rhkean/kicad_DemonEye/DemonEye.kicad_pcb

## KiCad design DemonEye.kicad_pcb (2026-07-26)

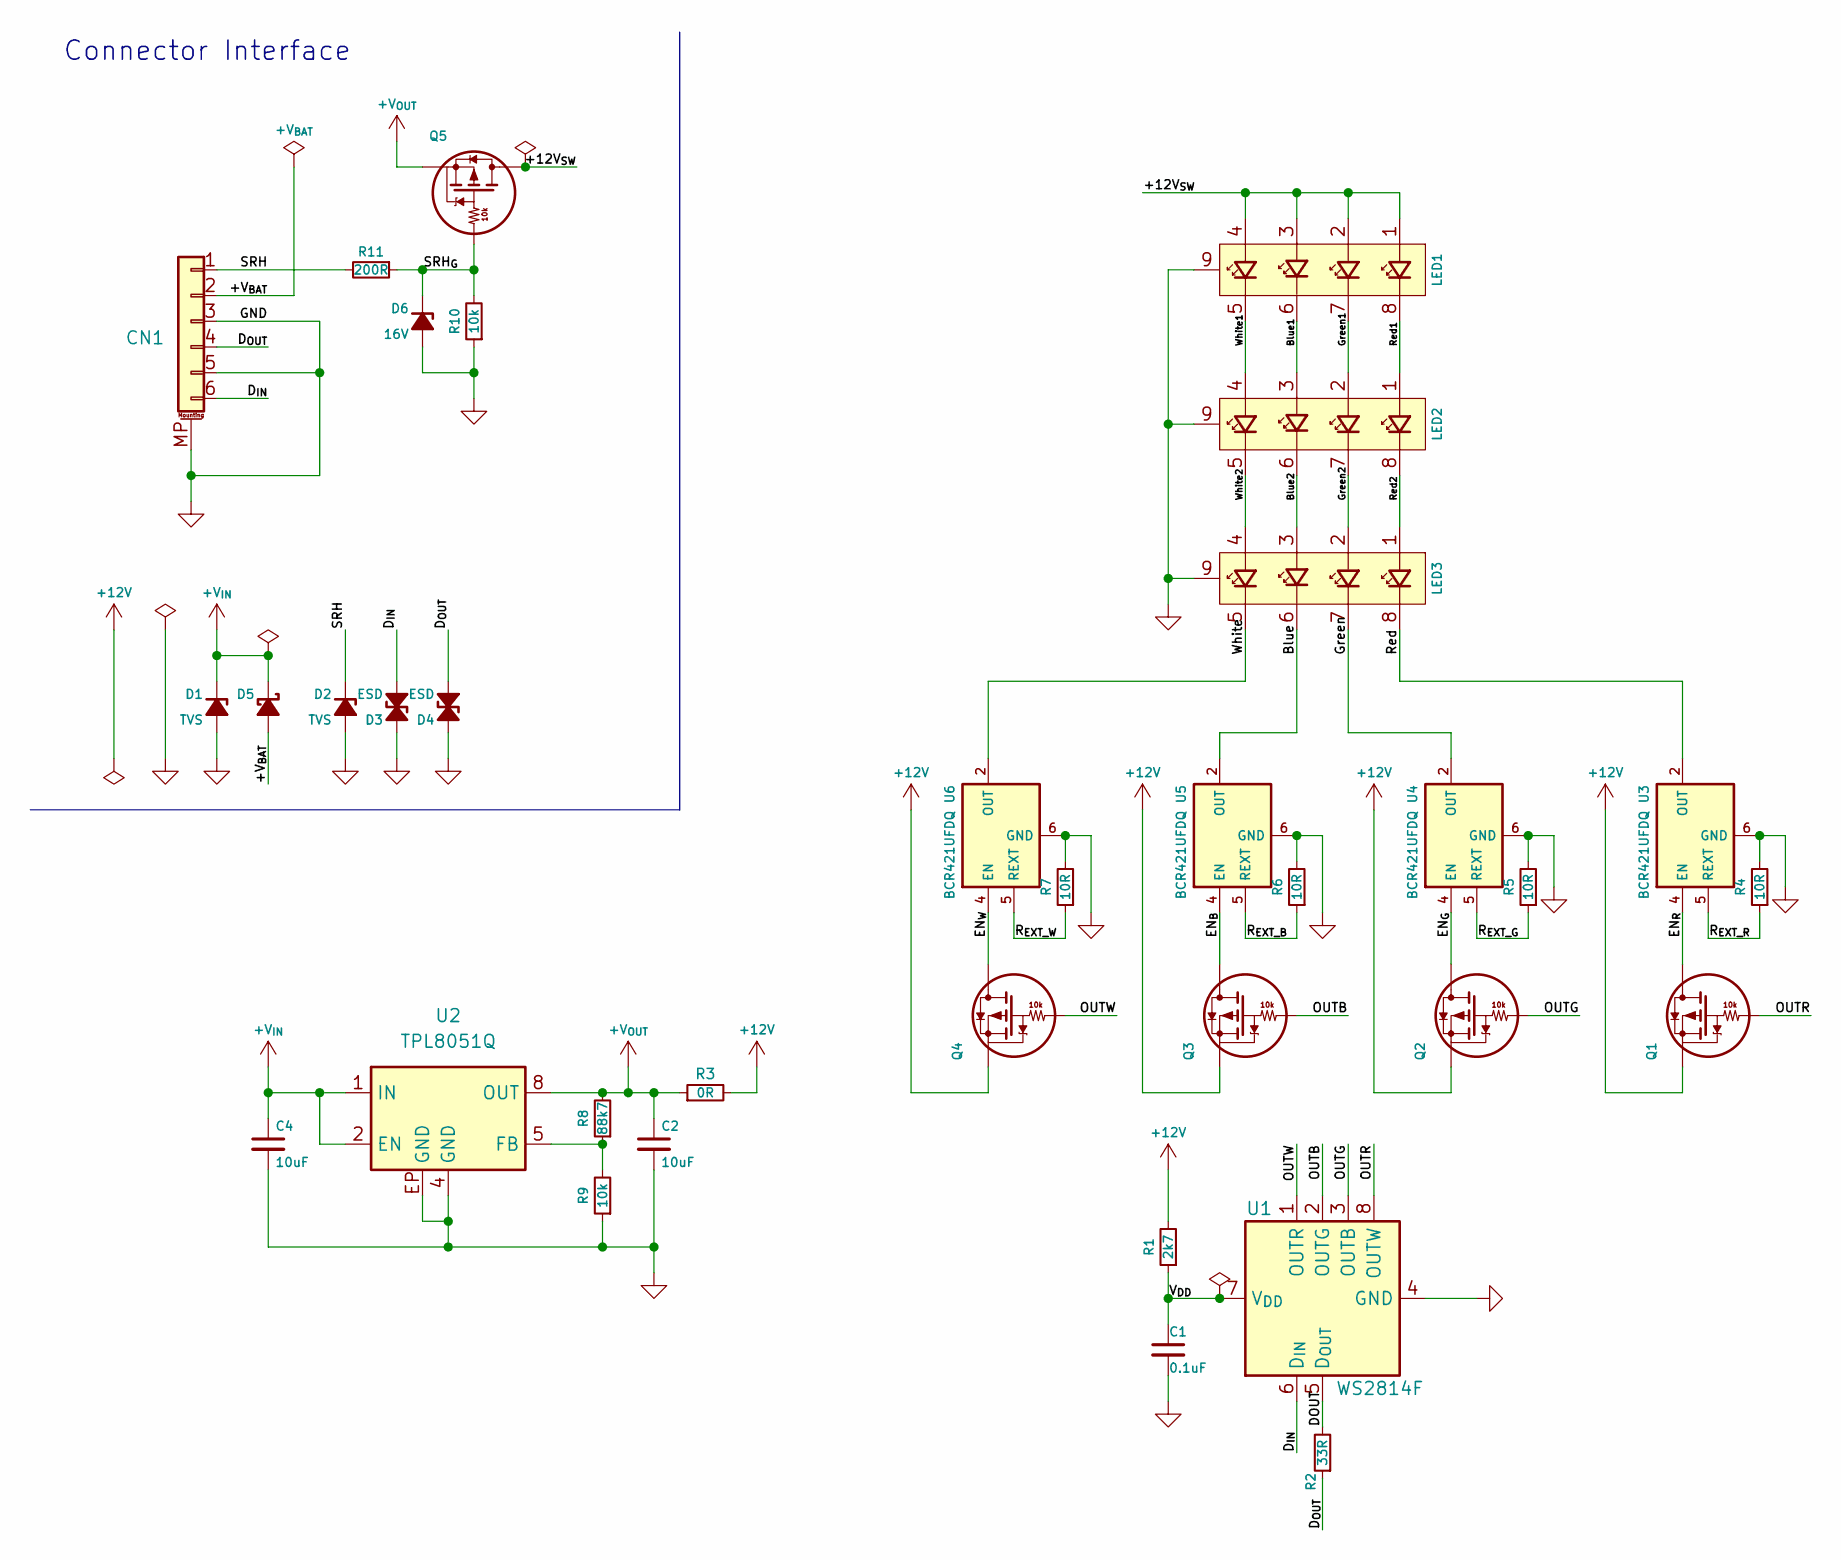
[picture p1: schematic DemonEye.kicad_sch]

Parts:
C1: 0.1uF; C_0201_Nominal; Manufacturer Part Number GRT033R61E104KE01D; LCSC C915760
C2, C4: 10uF; C_0805_Nominal; Manufacturer Part Number GCM21BC71E106KE36L; LCSC C5367383
CN1: PicoBlade 1x06 P1.25mm; Molex_PicoBlade_53261-0671_1x06_P1.25mm_Horizontal_SMD; Manufacturer Part Number HC-1.25-6PWT; LCSC C2845383
D1, D2: TVS; DFN1006-2; Manufacturer Part Number D15V0H1U2LP-7B; LCSC C1973850
D3, D4: ESD; DFN1006-2; Manufacturer Part Number SZESD7241N2T5G; LCSC C604770
D5: D_Schottky_Small_Filled; DFN1006-2; MPN NSVR05F40NXT5G; LCSC C604383
D6: 16V; DFN1006-2; Manufacturer Part Number BZX884-C16,315; LCSC C551222
LED1, LED2, LED3: QLSP06RGBXWAJ; Manufacturer Part Number QLSP06RGBXWAJ; LCSC C17645191
Q1, Q2, Q3, Q4, Q5: CSD25501F3; Texas_PICOSTAR-YJN_0.7x0.6mm_PicoStar; Manufacturer Part Number CSD25501F3; LCSC C2872196
R1: 2k7; R_0201_Dense; Manufacturer Part Number AC0201FR-072K7L; LCSC C226497
R2: 33R; R_0402_Nominal; Manufacturer Part Number AC0402FR-0733RL; LCSC C227000
R3: 0R; R_0603_Nominal; Manufacturer Part Number AC0603FR-070RL; LCSC C116699
R4, R5, R6, R7: 10R; R_0201_Dense; MPN AF0201FR-0710RL; LCSC C143979
R8: 88k7; R_0201_Dense; Manufacturer Part Number 0201WMF8872TEE; LCSC C423412
R9: 10k; R_0201_Dense; Manufacturer Part Number AC0201FR-0710KL; LCSC C144833
R10: 10k; R_0201_Nominal; Manufacturer Part Number AC0201FR-0710KL; LCSC C144833
R11: 200R; R_0402_Nominal; Manufacturer Part Number RC0402FR-07200RL; LCSC C114764
U1: WS2814F; FSOP-8_3.25x1.65mm_P0.8mm; Manufacturer Part Number WS2814F; LCSC C5446694
U2: TPL8051Q; DFN-8-1EP_3x3mm_P0.65mm_EP1.55x2.4mm; MPN TPL8051ADQ-DFCR-S; LCSC C48618279
U3, U4, U5, U6: BCR421UFDQ; Manufacturer Part Number BCR421UFDQ-7; LCSC C2678624

Connections:
+12V: Q1.2 (S), Q2.2 (S), Q3.2 (S), Q4.2 (S), R1.2, R3.2
+V_{IN}: C4.1, D1.1 (K), D5.1 (K), U2.1 (IN), U2.2 (EN)
+V_{OUT}: C2.1, Q5.2 (S), R3.1, R8.2, U2.8 (OUT)
/+12V_{SW}: LED1.1 (Red_A), LED1.2 (Green_A), LED1.3 (Blue_A), LED1.4 (White_A), Q5.3 (D)
/+V_{BAT}: CN1.2, D5.2 (A)
/Blue: LED3.6 (Blue_K), U5.2 (OUT)
/Blue1: LED1.6 (Blue_K), LED2.3 (Blue_A)
/Blue2: LED2.6 (Blue_K), LED3.3 (Blue_A)
/DOUT: R2.2, U1.5 (D_{OUT})
/D_{IN}: CN1.6 (Pin_4), D3.1 (A1), U1.6 (D_{IN})
/D_{OUT}: CN1.4, D4.1 (A1), R2.1
/EN_{B}: Q3.3 (D), U5.4 (EN)
/EN_{G}: Q2.3 (D), U4.4 (EN)
/EN_{R}: Q1.3 (D), U3.4 (EN)
/EN_{W}: Q4.3 (D), U6.4 (EN)
/Green: LED3.7 (Green_K), U4.2 (OUT)
/Green1: LED1.7 (Green_K), LED2.2 (Green_A)
/Green2: LED2.7 (Green_K), LED3.2 (Green_A)
/OUTB: Q3.1 (G), U1.2 (OUTG)
/OUTG: Q2.1 (G), U1.3 (OUTB)
/OUTR: Q1.1 (G), U1.8 (OUTW)
/OUTW: Q4.1 (G), U1.1 (OUTR)
/R_{EXT_B}: R6.1, U5.5 (REXT)
/R_{EXT_G}: R5.1, U4.5 (REXT)
/R_{EXT_R}: R4.1, U3.5 (REXT)
/R_{EXT_W}: R7.1, U6.5 (REXT)
/Red: LED3.8 (Red_K), U3.2 (OUT)
/Red1: LED1.8 (Red_K), LED2.1 (Red_A)
/Red2: LED2.8 (Red_K), LED3.1 (Red_A)
/SRH: CN1.1, D2.1 (K), R11.2
/SRH_{G}: D6.1 (K), Q5.1 (G), R10.2, R11.1
/V_{DD}: C1.1, R1.1, U1.7 (V_{DD})
/White: LED3.5 (White_K), U6.2 (OUT)
/White1: LED1.5 (White_K), LED2.4 (White_A)
/White2: LED2.5 (White_K), LED3.4 (White_A)
GND: C1.2, C2.2, C4.2, CN1.3, CN1.5 (Pin_4), CN1.MP (MountPin), D1.2 (A), D2.2 (A), D3.2 (A2), D4.2 (A2), D6.2 (A), LED1.9 (EP), LED2.9 (EP), LED3.9 (EP), R4.2, R5.2, R6.2, R7.2, R9.1, R10.1, U1.4 (GND), U2.4 (GND), U2.EP (GND), U3.6 (GND), U4.6 (GND), U5.6 (GND), U6.6 (GND)
unnamed: R8.1, R9.2, U2.5 (FB)

Notes on the sheet:
Connector Interface

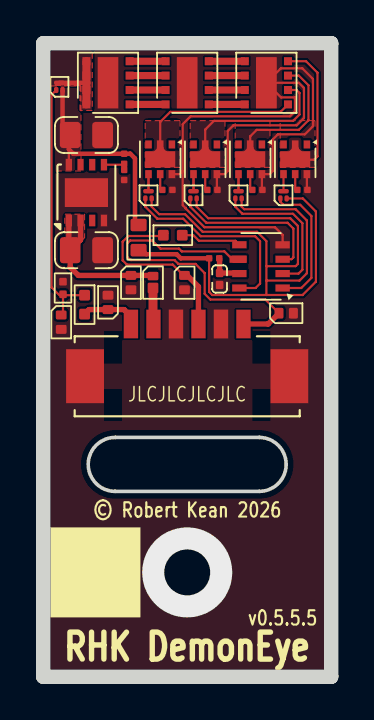
[picture p2: board DemonEye.kicad_pcb from above]

Board: 2 copper layers, 16.0 x 35.2 mm, 35 parts (0 on the bottom side), 37 nets.
