rhkean/kicad_DemonEye/(commit log)

2026-05-24 Update .gitignore, DemonEye.kicad_pcb, DemonEye.kicad_prl, and 3 more files
    [DemonEye.kicad_pcb, DemonEye.kicad_sch]
2026-06-04 Update ConstantCurrentWithThermalFoldbackDesign.txt, DemonEye.kicad_pcb, DemonEye.kicad_prl, and 3 more files
    [DemonEye.kicad_pcb, DemonEye.kicad_sch]
2026-06-04 Update DemonEye.kicad_pcb, corrected FemtoFET footprint
    [DemonEye.kicad_pcb]
2026-06-05 improved spacing on components between pad and silkscreen. required some shifting of components on board
    [BOM-DemonEye.csv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]
2026-06-05 forgot to hit save
    [DemonEye.kicad_sch]
2026-06-05 final revision/sync after messing up other repo and cleaning up silkscreen and pad overlap. Added EP pad for the BJT
    [DemonEye.kicad_pcb, DemonEye.kicad_sch]
2026-06-14 JLCPCB 2026-06-03 11:50:17 PCB: Y60-5297522A PCBA: SMT026060362708-5297522A
    [DemonEye.kicad_sch]
2026-06-23 Update DemonEye.kicad_pcb, DemonEye.kicad_prl, DemonEye.kicad_pro, and 8 more files
    [BOM-DemonEye.csv, DemonEye.kicad_pcb, DemonEye.kicad_sch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]
2026-07-25 Update .gitignore, DemonEye.kicad_pcb, DemonEye.kicad_prl, and 17 more files
    [DemonEye.kicad_pcb, DemonEye.kicad_sch]
2026-07-25 Update WS2814A.kicad_mod and WS2814B.kicad_mod
2026-07-26 reworked the protection circuitry for the SRH signal to protect the PFET from surges and >16V load dumps
    [DemonEye.kicad_pcb, DemonEye.kicad_sch]
