rhkean/kicad_DemonEye/(notices)

Notices in the files:
DemonEye.kicad_pcb:
© Robert Kean 2026
